leoki6/ENCE-4321/Phase_B/PCB_Design/V2/Phase_B_ATMEGA_v3/plots/Dimension_img.JPG

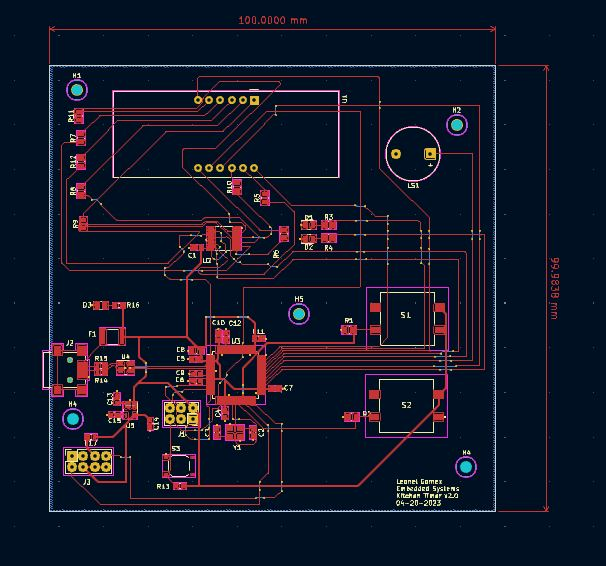
Phase_B/PCB_Design/V2/Phase_B_ATMEGA_v3/plots/Dimension_img.JPG
