leoki6/ENCE-4321/Phase_B/PCB_Design/V2/README.txt

The initial version of the folder Phase_B_ATMEGA_v3 was a template provided by Professor Martins
in ENCE-4231.

Files pertaining to the generation/creation of: housing, component placement, PCB dimensioning, Drill, Gerber, 3D Models, etc
were created by the author of this repository.
