leoki6/ENCE-4321/Phase_B/PCB_Design/V2/Phase_B_ATMEGA_v3/enclosure/V2/notes.txt

This version has the corner fillets removed and more accurately represents the true size of the PCB board.
