leoki6/ENCE-4321/Phase_D/Notes/block_diagram.pdf

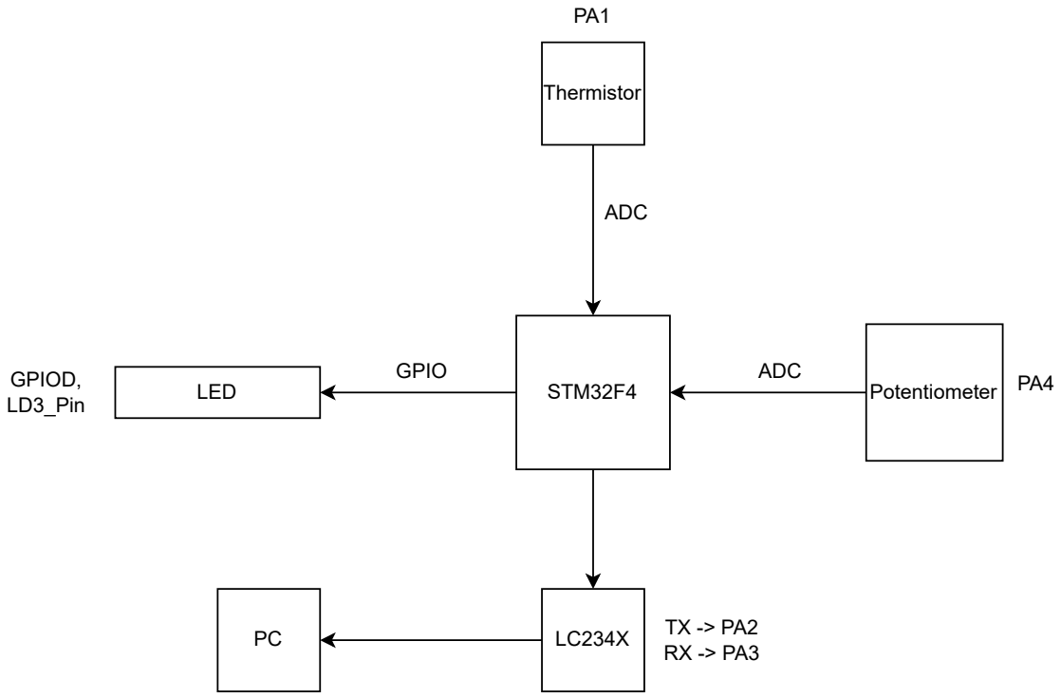
[picture p15: figure]
STM32F4; Thermistor; LED; Potentiometer GPIOD,; LD3_Pin; GPIO; ADC
