leoki6/ENCE-4321/Phase_B/Notes/Block_Diagrams/Phase_B_Sys_Diagram.pdf

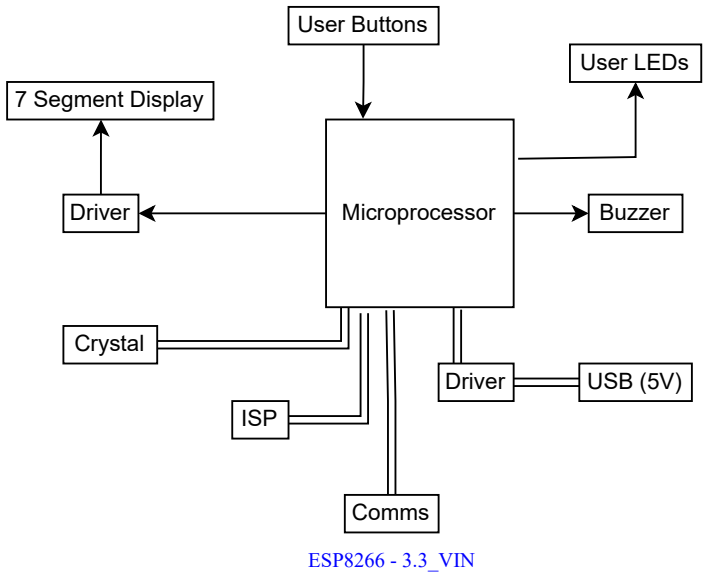
[picture p16: figure]
Microprocessor; User LEDs; User Buttons; Buzzer; USB (5V); Comms; ISP; Crystal; 7 Segment Display; Driver; ESP8266 - 3.3_VIN

Voltage Regulator

5V | 3V

Leonel Gomez; ENCE-4231; Phase_B_Sys_Diagram
