leoki6/ENCE-4321/Phase_B/PCB_Design/CURRENT/Phase_B_ATMEGA_v3/plots/kicad_backview.JPG

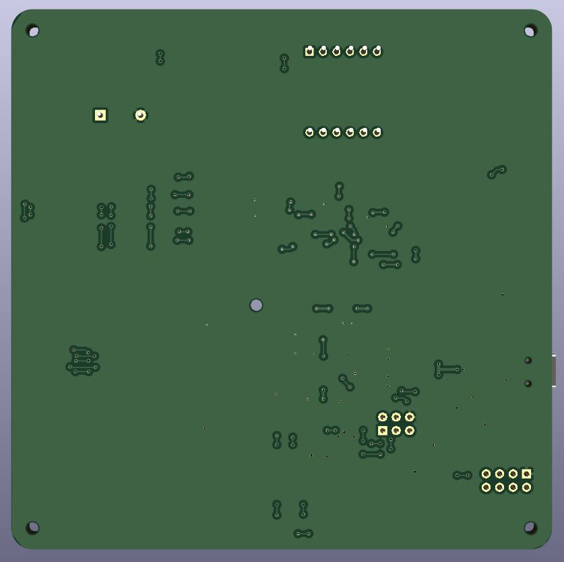
Phase_B/PCB_Design/CURRENT/Phase_B_ATMEGA_v3/plots/kicad_backview.JPG
