leoki6/ENCE-4321/Phase_B/PCB_Design/CURRENT/Phase_B_ATMEGA_v3/schematics/schematic.JPG

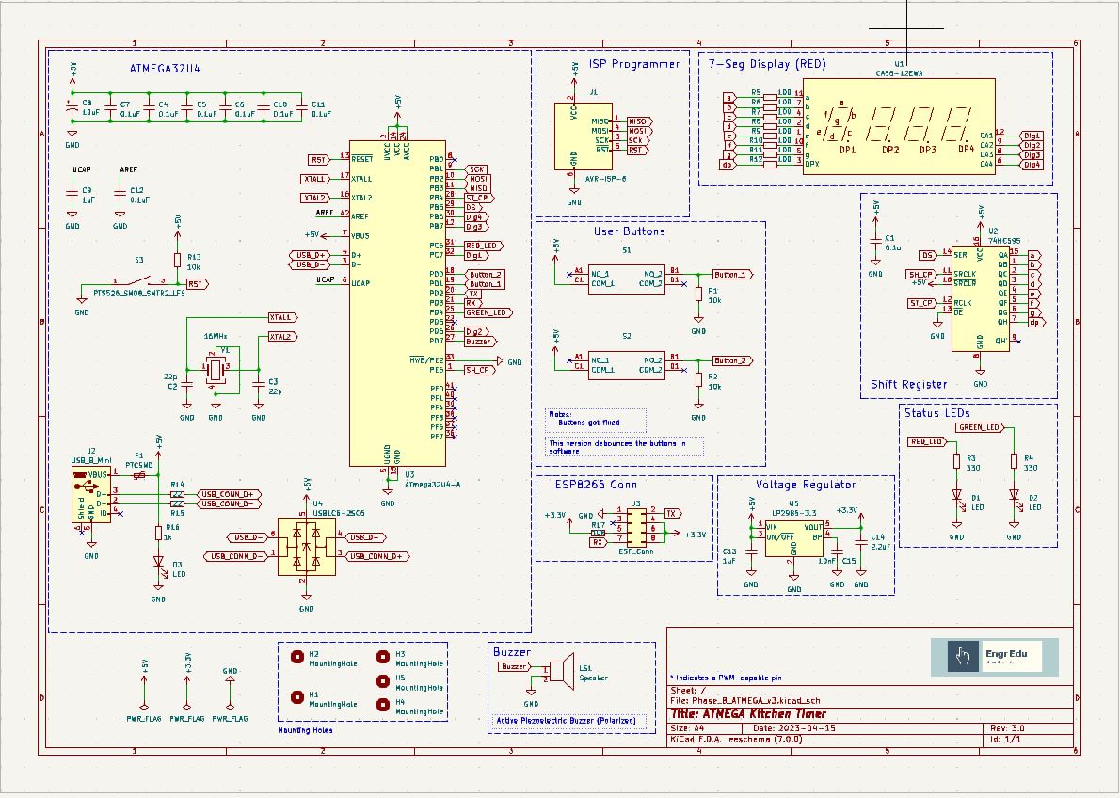
Phase_B/PCB_Design/CURRENT/Phase_B_ATMEGA_v3/schematics/schematic.JPG
