leoki6/ENCE-4321/Phase_D/Notes/simple_schematic.PNG

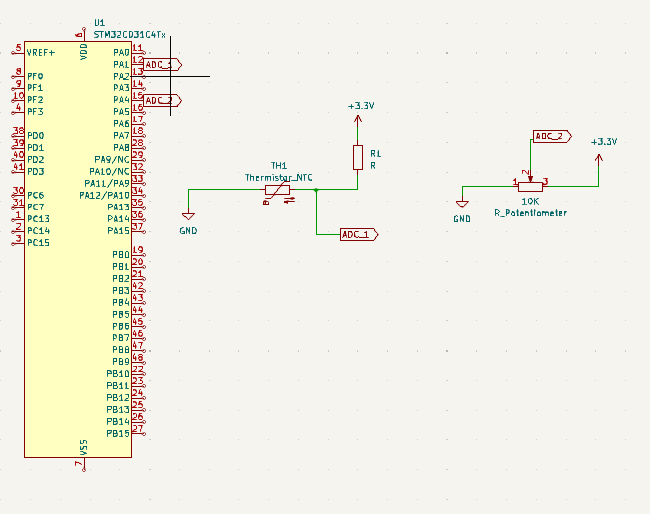
Phase_D/Notes/simple_schematic.PNG
