leoki6/ENCE-4321/Phase_D/PCB_Design/V1/plots/pcb_img.PNG

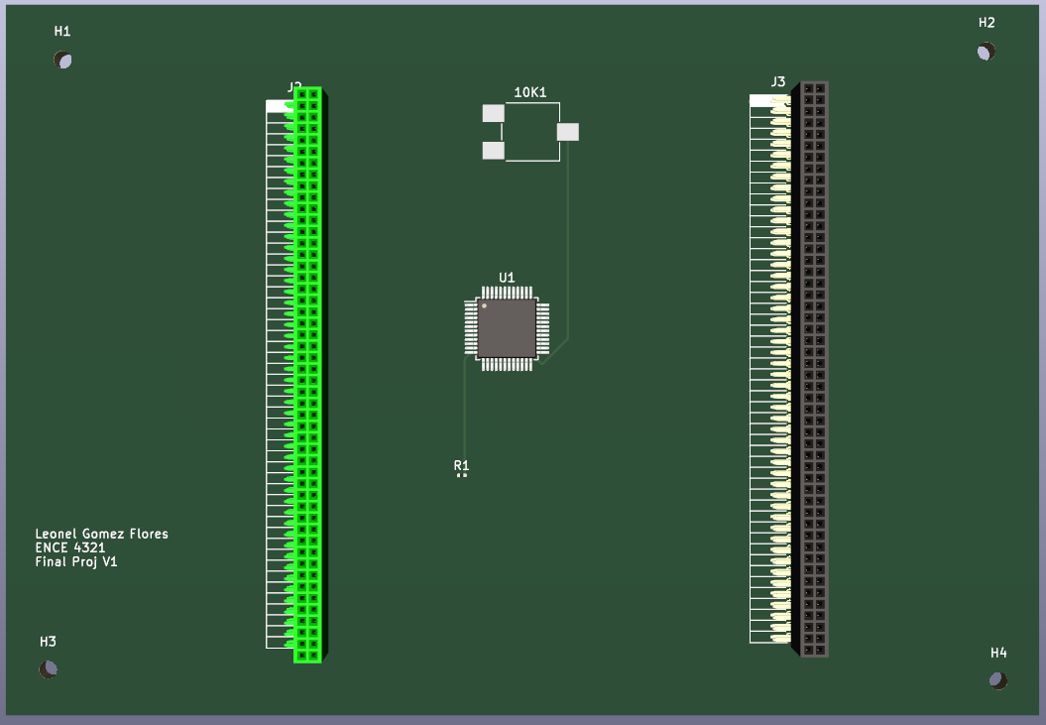
Phase_D/PCB_Design/V1/plots/pcb_img.PNG
