leoki6/ENCE-4321/Phase_D/PCB_Design/V1/schematics/schematic_img_v2.PNG

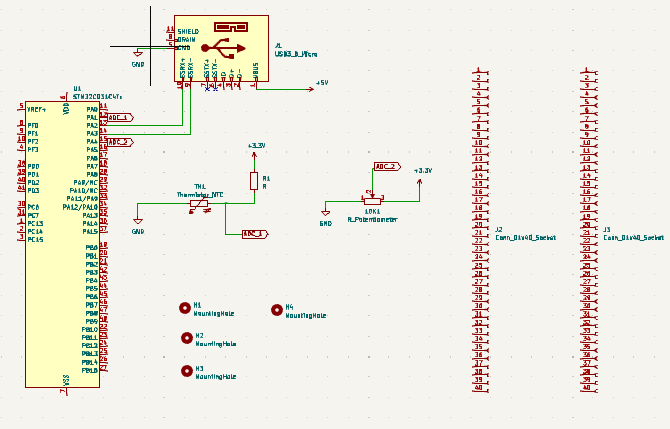
Phase_D/PCB_Design/V1/schematics/schematic_img_v2.PNG
