leoki6/ENCE-4321/Phase_B/PCB_Design/CURRENT/Phase_B_ATMEGA_v3/plots/DXF_Files/Phase_B_ATMEGA_v3-F_Cu.dxf

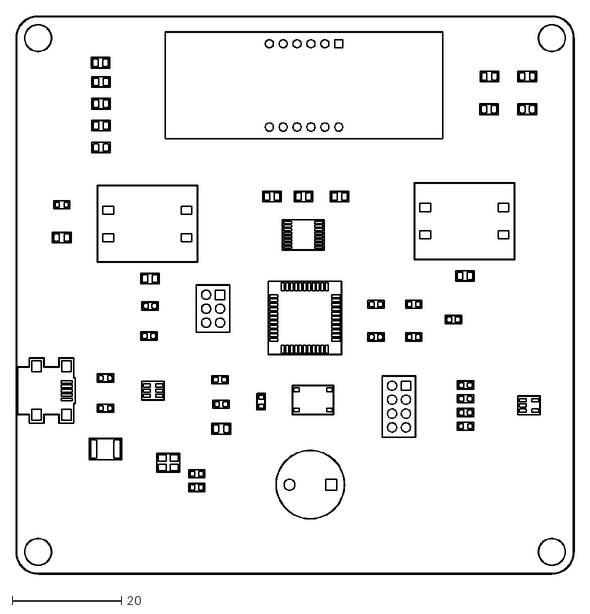
[picture p26: CAD file, 2023-04-18]
Phase_B/PCB_Design/CURRENT/Phase_B_ATMEGA_v3/plots/DXF_Files/Phase_B_ATMEGA_v3-F_Cu.dxf
102.1 x 102.1
