leoki6/ENCE-4321/Phase_B/PCB_Design/CURRENT/Phase_B_ATMEGA_v3/PTS125SM73SMTR21M_LFS.stp

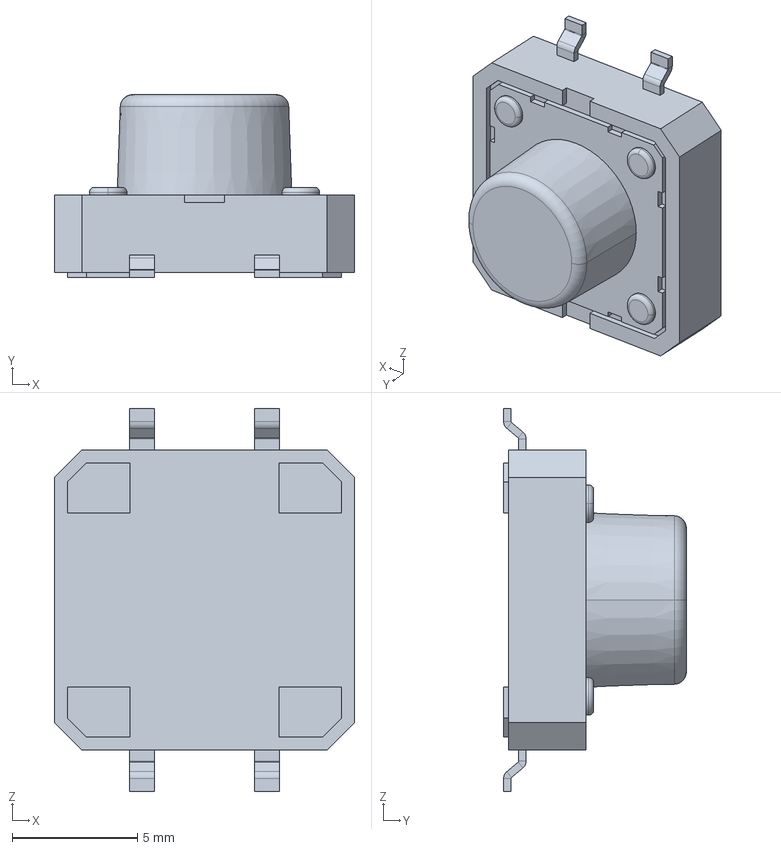
[picture p27: CAD file, 2023-04-18]
Phase_B/PCB_Design/CURRENT/Phase_B_ATMEGA_v3/PTS125SM73SMTR21M_LFS.stp
12.0 x 7.30 x 15.3 mm
