leoki6/ENCE-4321/Phase_B/PCB_Design/CURRENT/Phase_B_ATMEGA_v3/step/SW1_SW2_Models/PTS526_SM08_SMTR2_LFS.stp

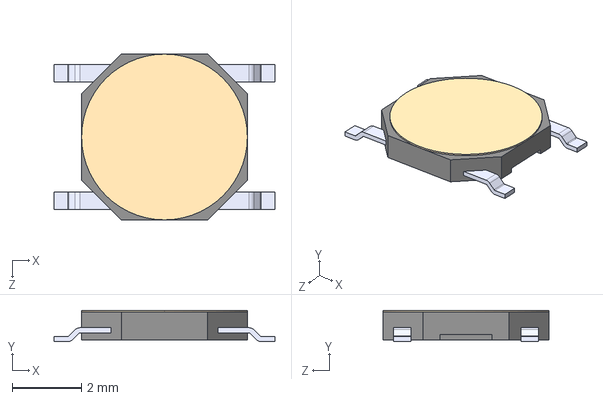
[picture p28: CAD file, 2023-04-18]
Phase_B/PCB_Design/CURRENT/Phase_B_ATMEGA_v3/step/SW1_SW2_Models/PTS526_SM08_SMTR2_LFS.stp
6.40 x 0.9 x 4.80 mm
