leoki6/ENCE-4321/Phase_B/PCB_Design/V2/Phase_B_ATMEGA_v3/components/PTS125_SMD_Button/STEP/PTS125_SMD_Button.stp

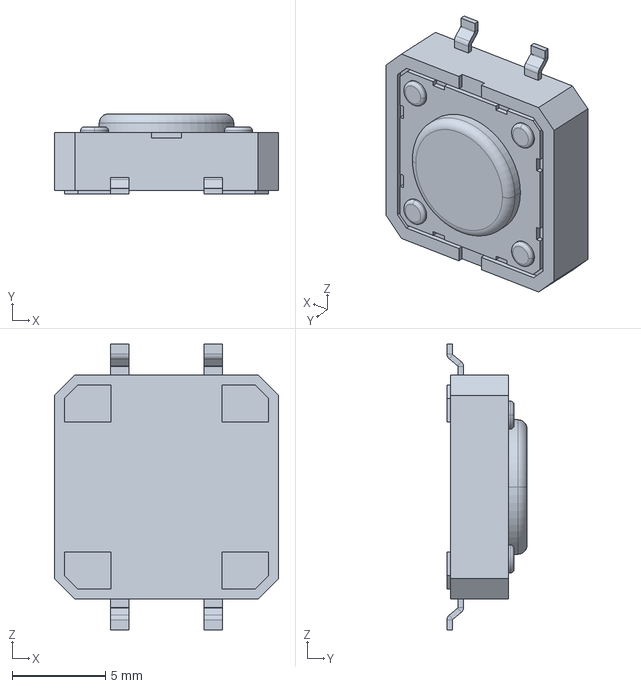
[picture p29: CAD file, 2023-04-12]
Phase_B/PCB_Design/V2/Phase_B_ATMEGA_v3/components/PTS125_SMD_Button/STEP/PTS125_SMD_Button.stp
12.0 x 4.30 x 15.3 mm
