leoki6/ENCE-4321/Phase_B/PCB_Design/V2/Phase_B_ATMEGA_v3/enclosure/V2/4.SLDPRT

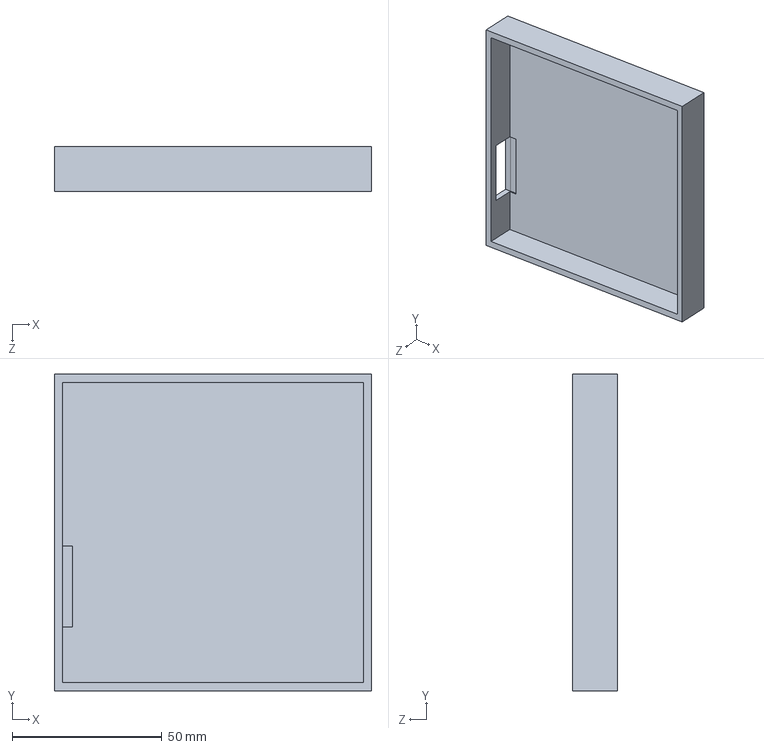
[picture p30: CAD file, 2023-05-04]
Phase_B/PCB_Design/V2/Phase_B_ATMEGA_v3/enclosure/V2/4.SLDPRT
106.0 x 106.0 x 15.0 mm
