leoki6/ENCE-4321/Phase_B/PCB_Design/V2/Phase_B_ATMEGA_v3/gerber/Phase_B_ATMEGA_v3-F_Cu.dxf

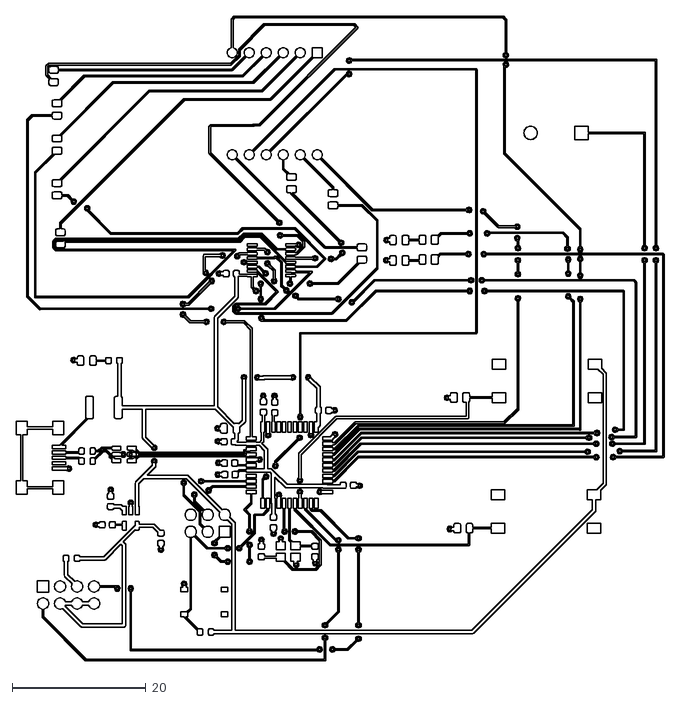
[picture p31: CAD file, 2023-05-04]
Phase_B/PCB_Design/V2/Phase_B_ATMEGA_v3/gerber/Phase_B_ATMEGA_v3-F_Cu.dxf
96.7 x 96.2
