leoki6/ENCE-4321/Phase_B/PCB_Design/V2/Phase_B_ATMEGA_v3/enclosure/V1/part.SLDPRT

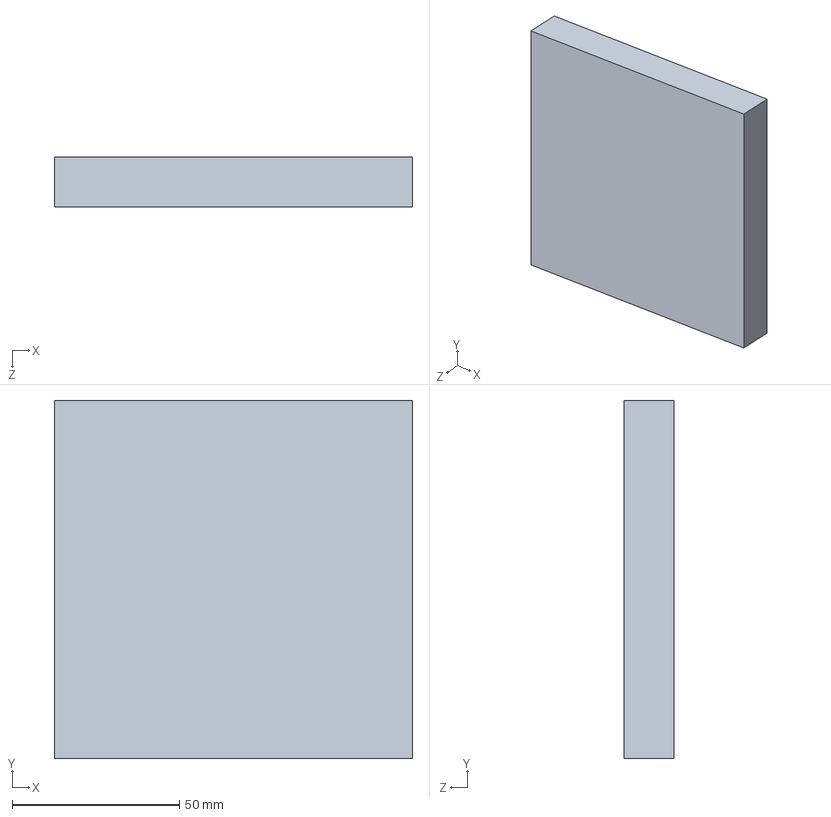
[picture p32: CAD file, 2023-04-18, an earlier design]
Phase_B/PCB_Design/V2/Phase_B_ATMEGA_v3/enclosure/V1/part.SLDPRT
107.0 x 107.0 x 15.0 mm
