leoki6/ENCE-4321/(list of files, cad)

Other CAD files:
Phase_B/PCB_Design/V2/Phase_B_ATMEGA_v3/components/PTS526_SMD_Button/STEP/PTS526_SMD_Button.step
Phase_B/PCB_Design/V2/Phase_B_ATMEGA_v3/enclosure/V2/housing_sld_part.SLDDRW
