leoki6/ENCE-4321/Phase_A/PCB_Design/Phase_A_UnoShield/schematics/Phase_A_UnoShield.pdf

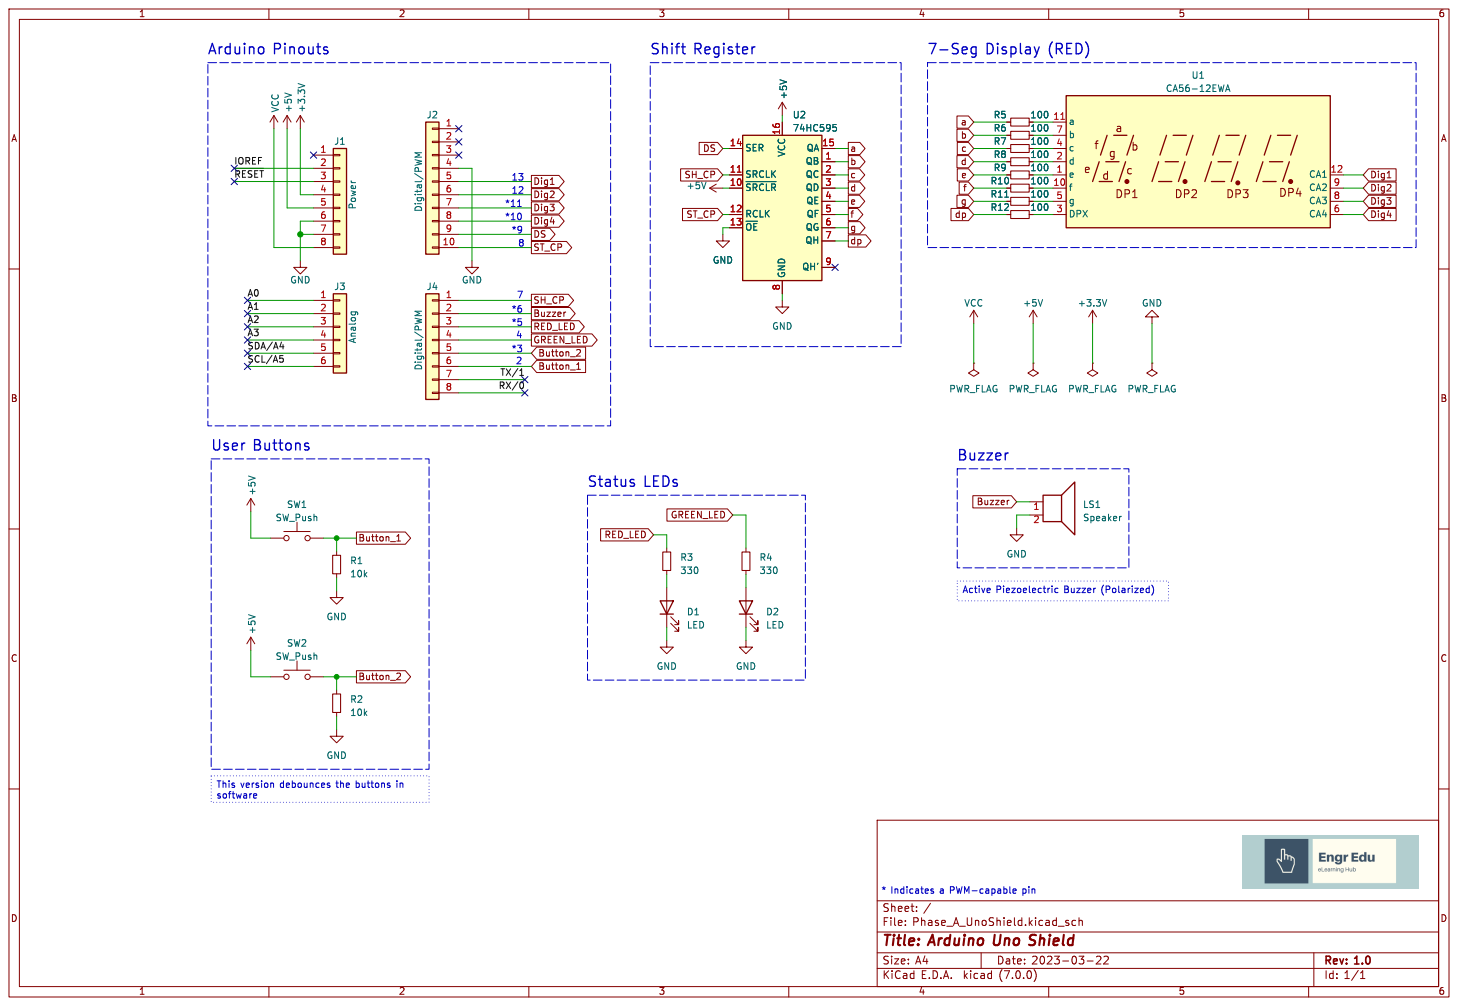
[picture p33: page 1]

Id: 1/1 Title: Arduino Uno Shield
