leoki6/ENCE-4321/Phase_B/PCB_Design/CURRENT/Phase_B_ATMEGA_v3/schematics/Phase_B_ATMEGA_v3.pdf

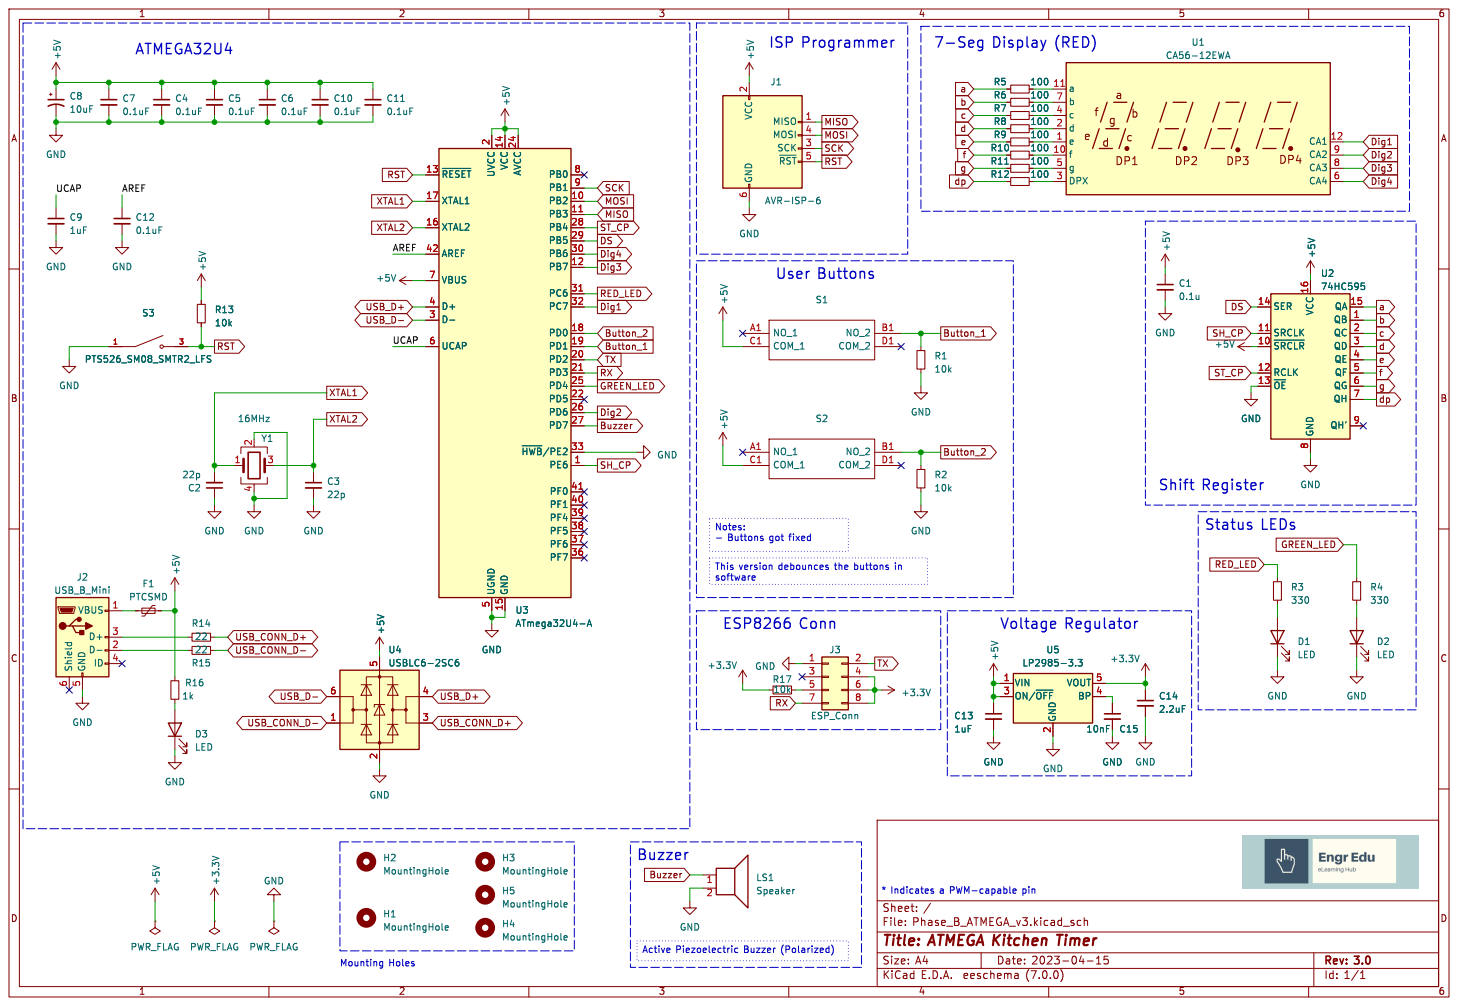
[picture p34: page 1]

2 SCK 3 MOSI 4 ~{RST}5 GND
22 GND

2 ON/~{OFF} 3 BP 4 VOUT 5 U5

2 ON/~{OFF} 3 BP 4 VOUT 5

Id: 1/1 Title: ATMEGA Kitchen Timer File: Phase_B_ATMEGA_v3.kicad_sch Sheet: / GND
