leoki6/ENCE-4321/Phase_B/PCB_Design/CURRENT/Phase_B_ATMEGA_v3/plots/Phase_B_ATMEGA_v3.pdf

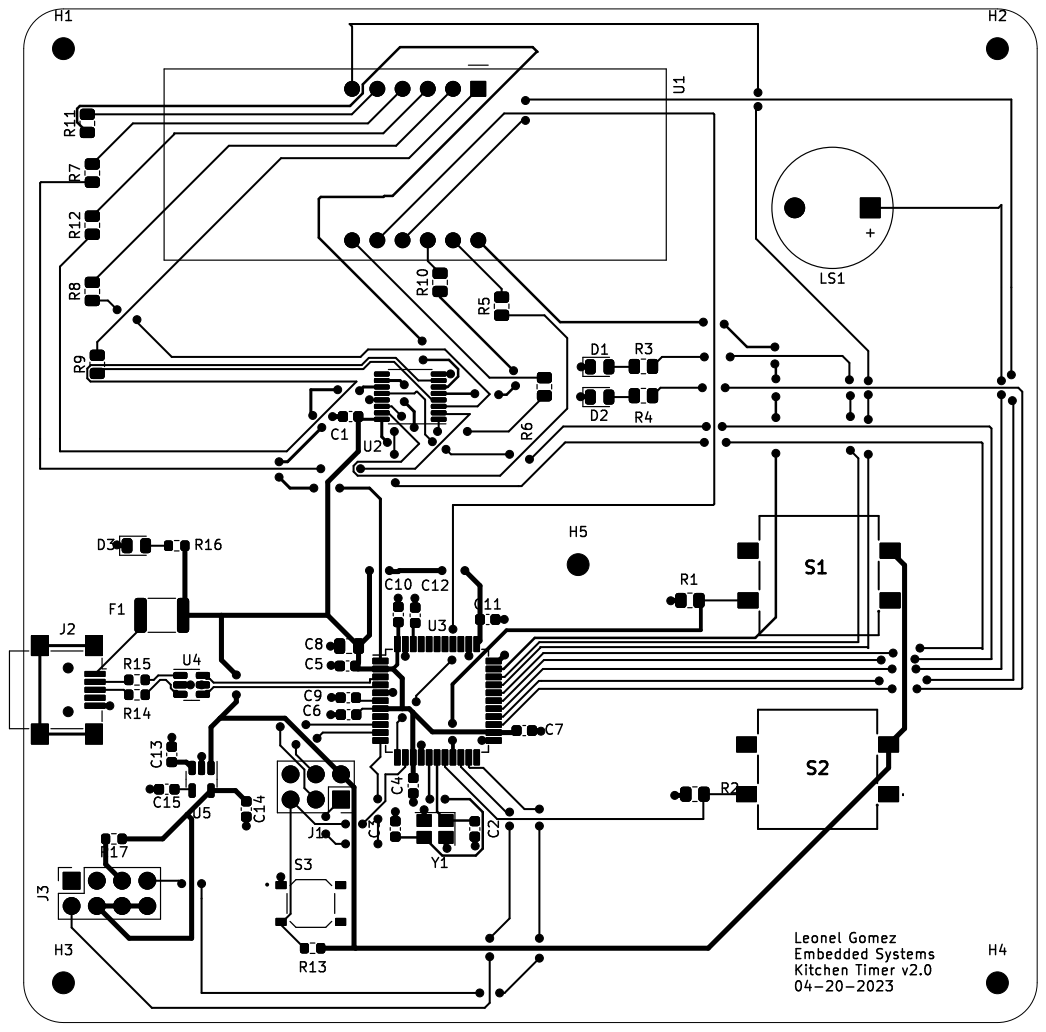
[picture p35: page 1]

Leonel Gomez Embedded Systems Kitchen Timer v2.0
