leoki6/ENCE-4321/Phase_B/PCB_Design/V2/Phase_B_ATMEGA_v3/enclosure/V2/Phase_B_Housing.pdf

6

5

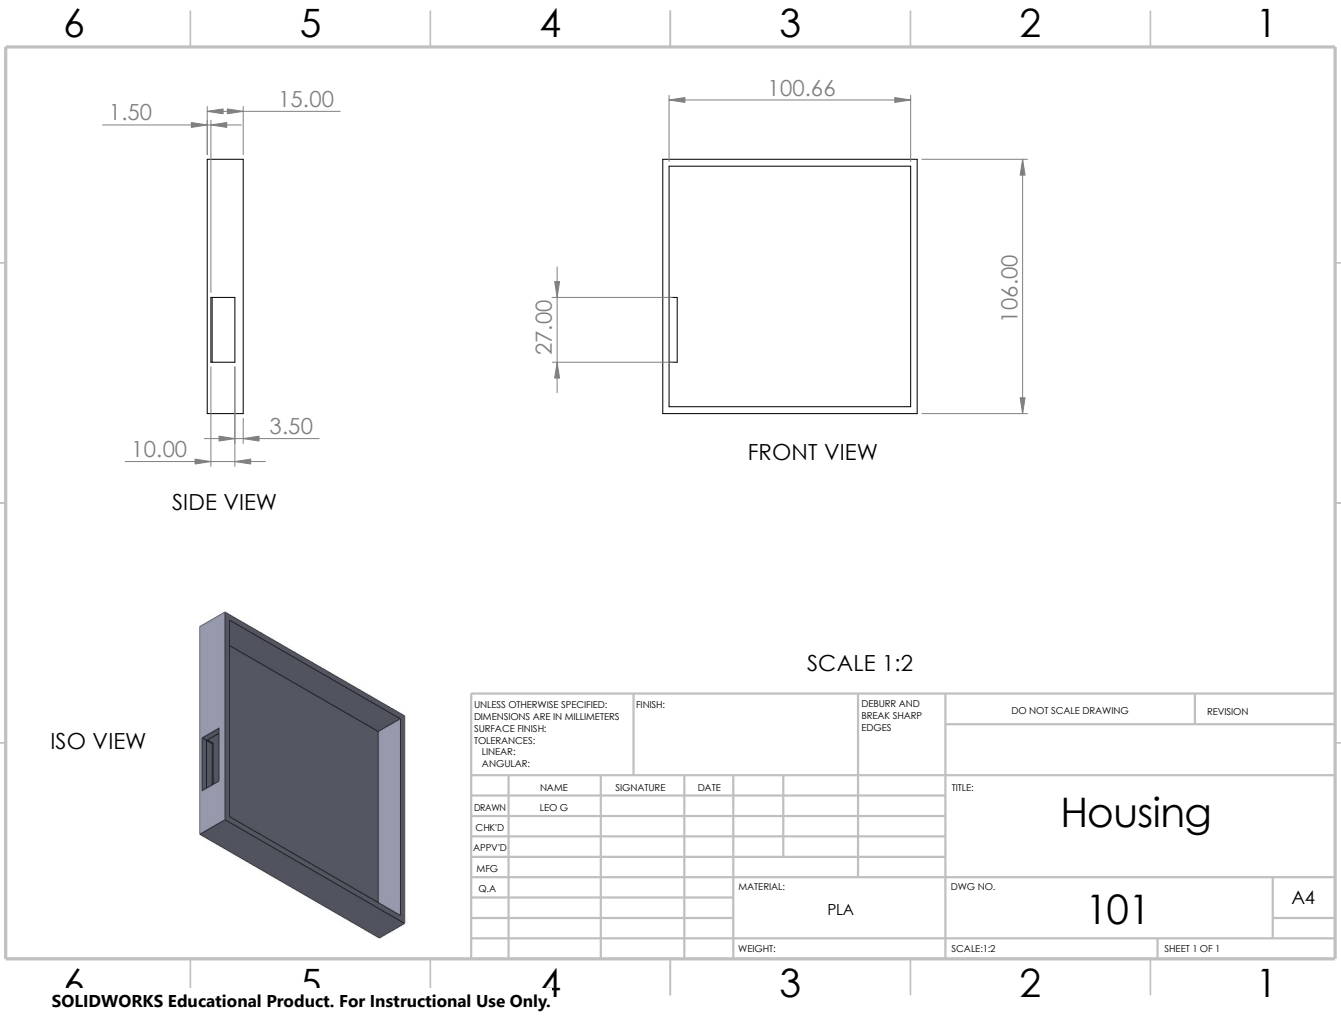
[picture p36: page 1]
WEIGHT:; SHEET 1 OF 1; FINISH:; EDGES; DO NOT SCALE DRAWING; REVISION; SCALE:1:2; DEBURR AND BREAK SHARP; SIDE VIEW; ISO VIEW; SCALE 1:2; FRONT VIEW

UNLESS OTHERWISE SPECIFIED:
DIMENSIONS ARE IN MILLIMETERS
SURFACE FINISH:
TOLERANCES:
LINEAR:
ANGULAR:

NAME | SIGNATURE | DATE | | | | TITLE: Housing

DRAWN | LEO G
CHK'D
APPV'D
Q.A | | | | MATERIAL: PLA | DWG NO. 101 | A4

MFG

SOLIDWORKS Educational Product. For Instructional Use Only.
