leoki6/ENCE-4321/Phase_A/Notes/Interrupt_Polling_Diagram.pdf

### MAIN

### Button_1_ISR

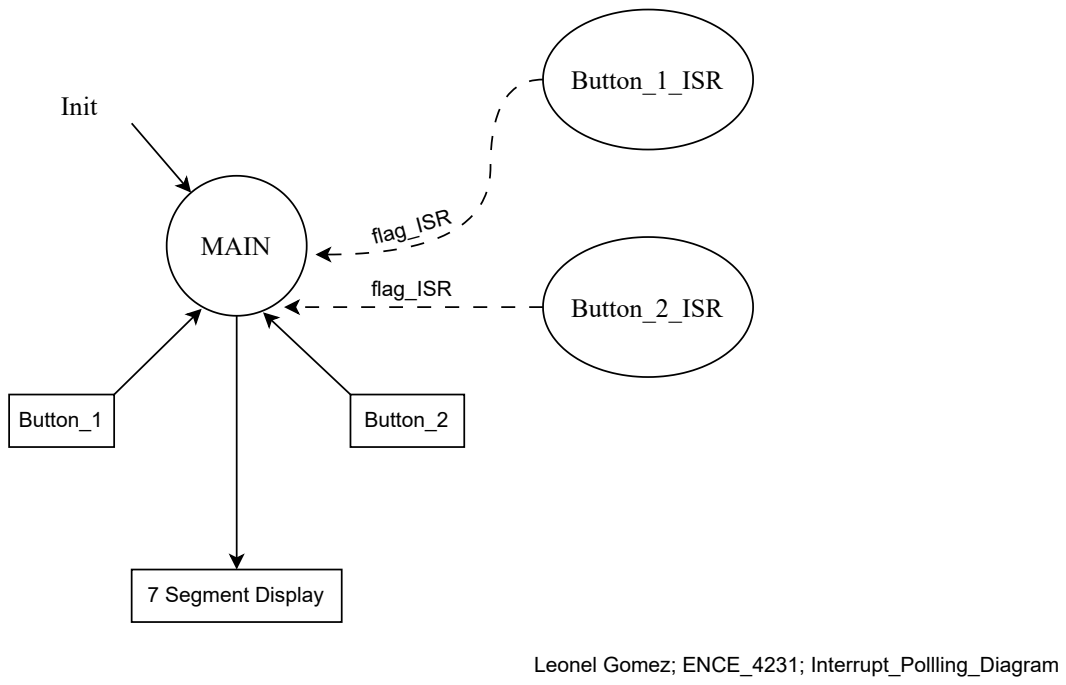
[picture p37: page 1]
Button_2_ISR; Init; Leonel Gomez; ENCE_4231; Interrupt_Pollling_Diagram; flag_ISR; 7 Segment Display; Button_1; Button_2
