leoki6/ENCE-4321/Phase_A/Notes/Simple_Counter_Diagram.pdf

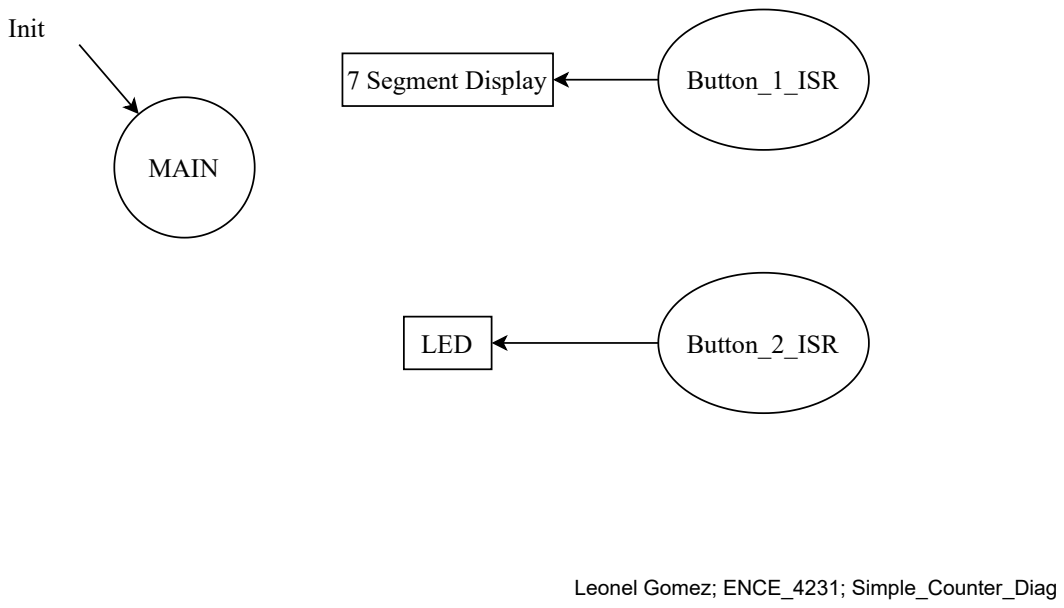
[picture p38: page 1]
MAIN; Button_1_ISR; Button_2_ISR; 7 Segment Display; LED; Init; Leonel Gomez; ENCE_4231; Simple_Counter_Diag
