leoki6/ENCE-4321/Phase_B/Notes/Block_Diagrams/soft_block_diag.pdf

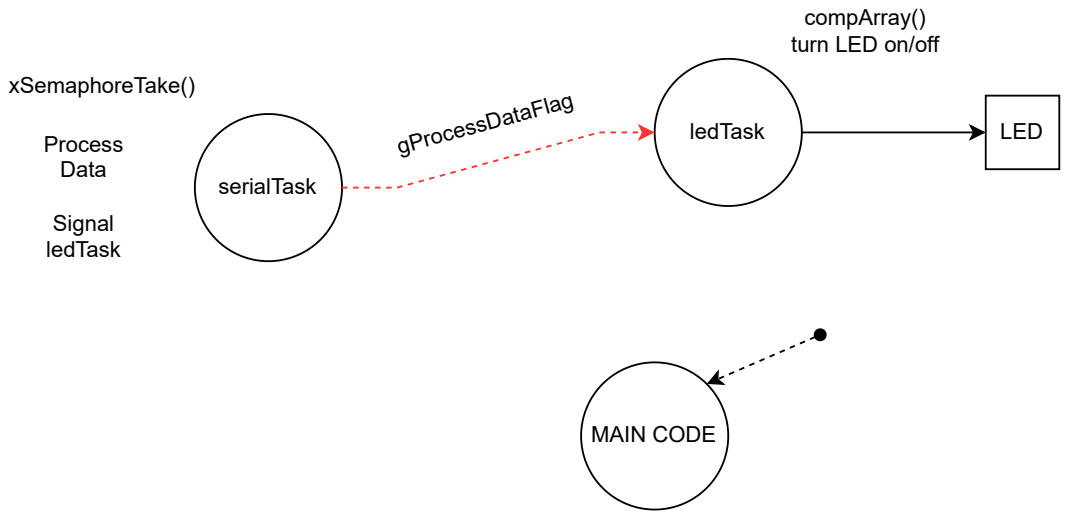
[picture p39: page 1]
MAIN CODE; LED; serialTask; ledTask gProcessDataFlag; xSemaphoreTake(); Process Data; Signal ledTask

compArray()
turn LED on/off
