leoki6/ENCE-4321/Phase_D/Notes/wiring_diag.pdf

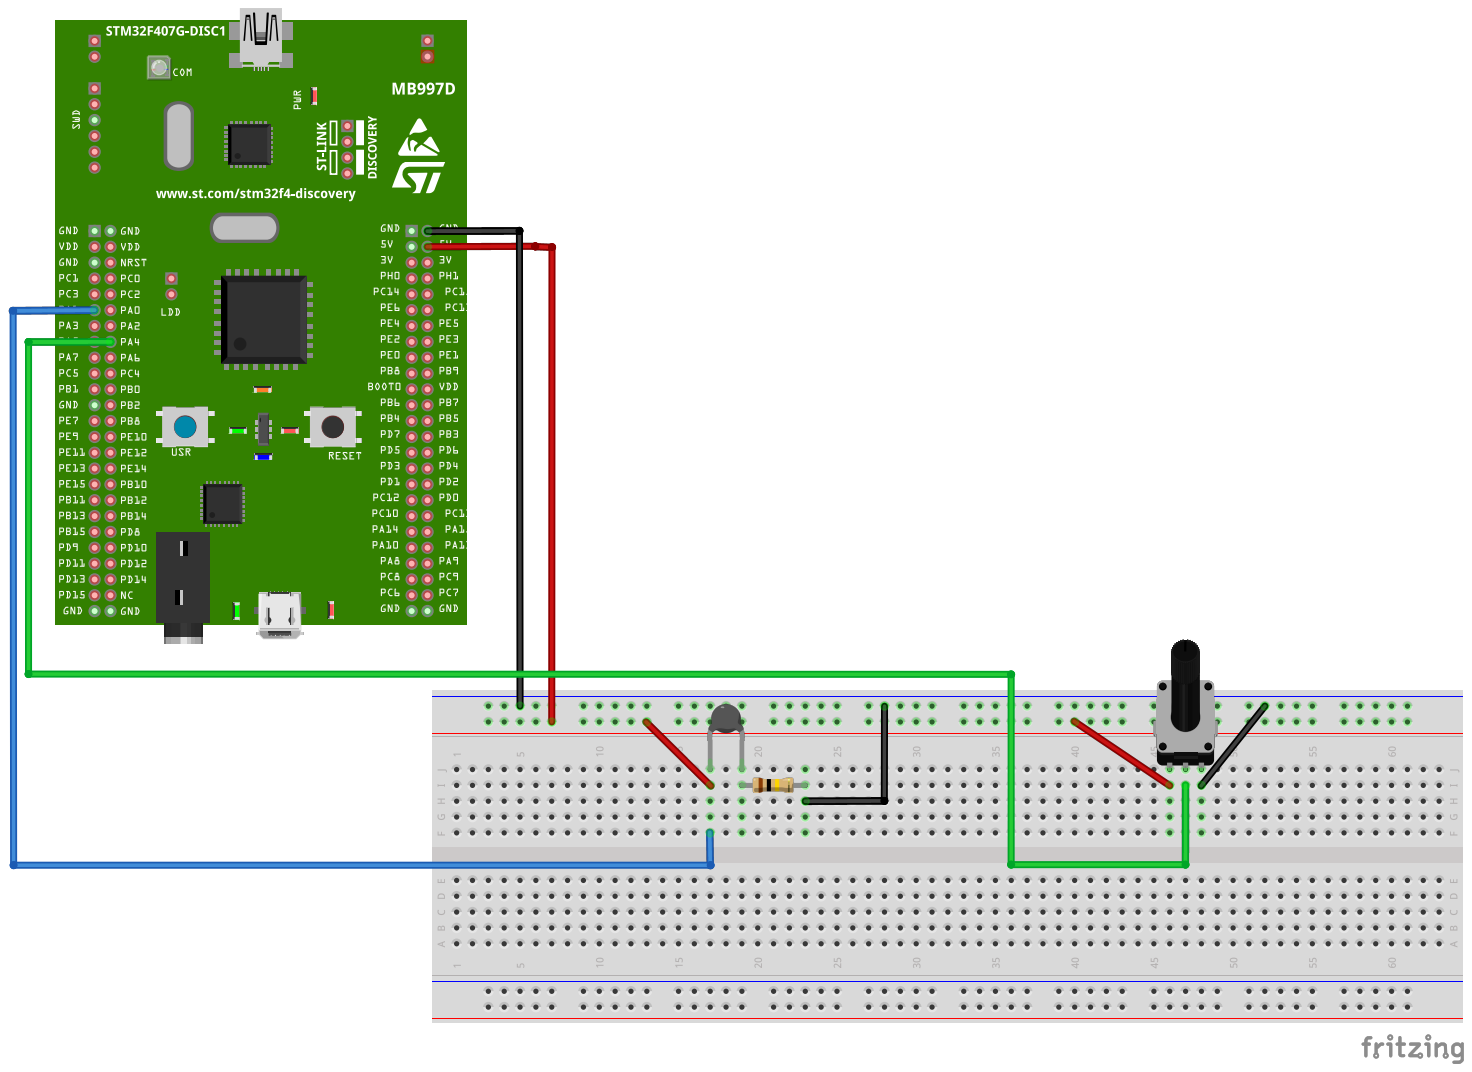
[picture p40: page 1]
