leoki6/ENCE-4321/Phase_D/PCB_Design/V1/schematics/schematic_kiCAD_v2.pdf

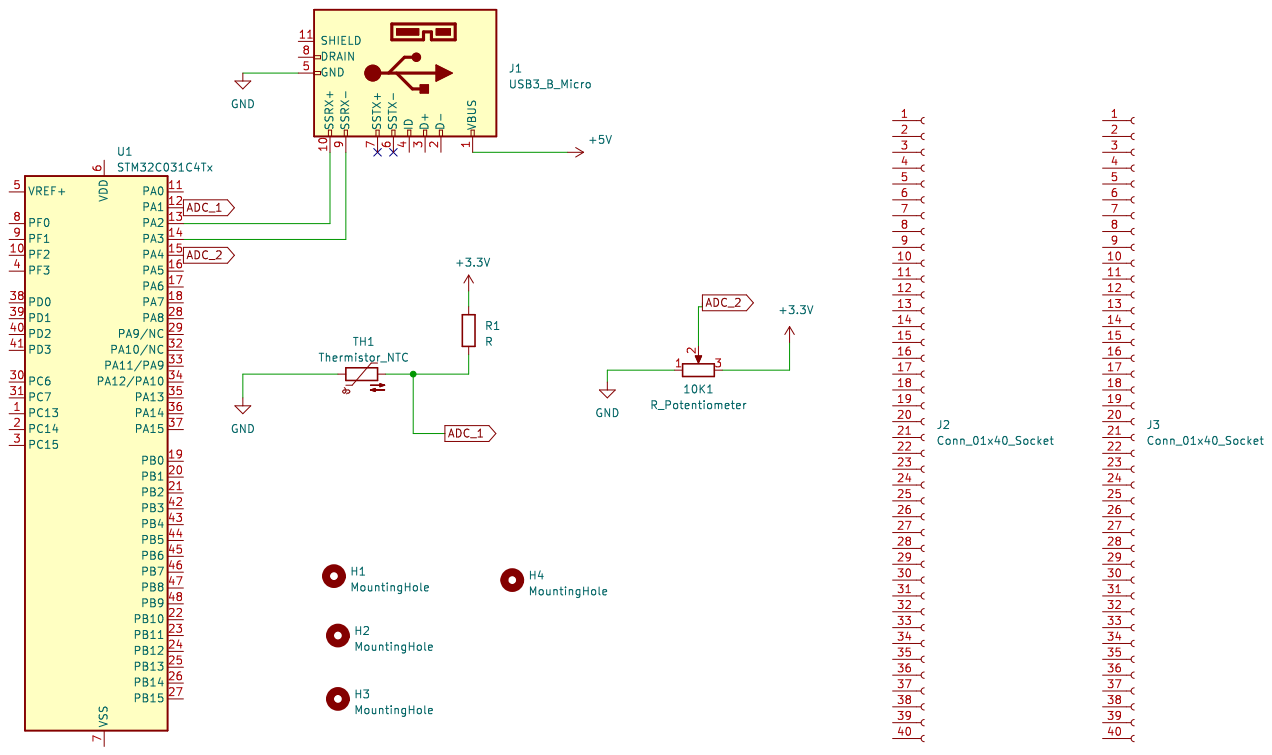
[picture p41: page 1]
