leoki6/ENCE-4321/Phase_A/PCB_Design/Phase_A_UnoShield/schematics/arduino_schematics.pdf

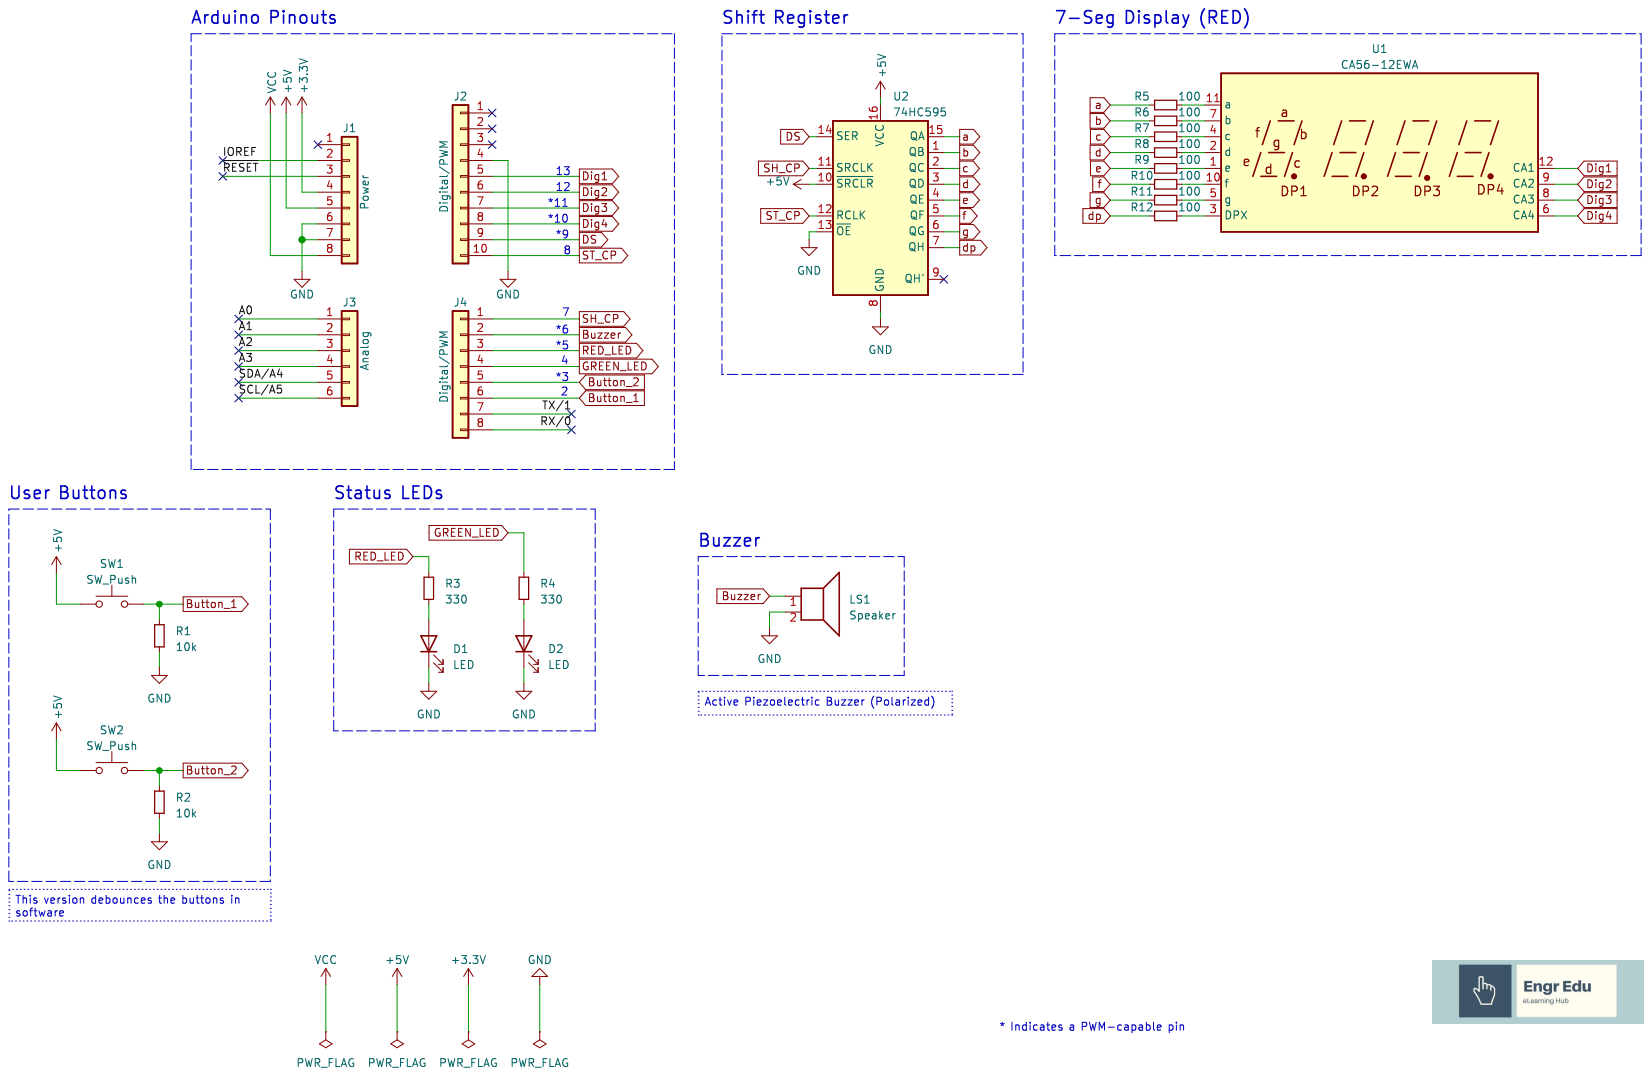
[picture p42: page 1]
