leoki6/ENCE-4321/Phase_D/PCB_Design/V1/schematics/schematic_kiCAD.pdf

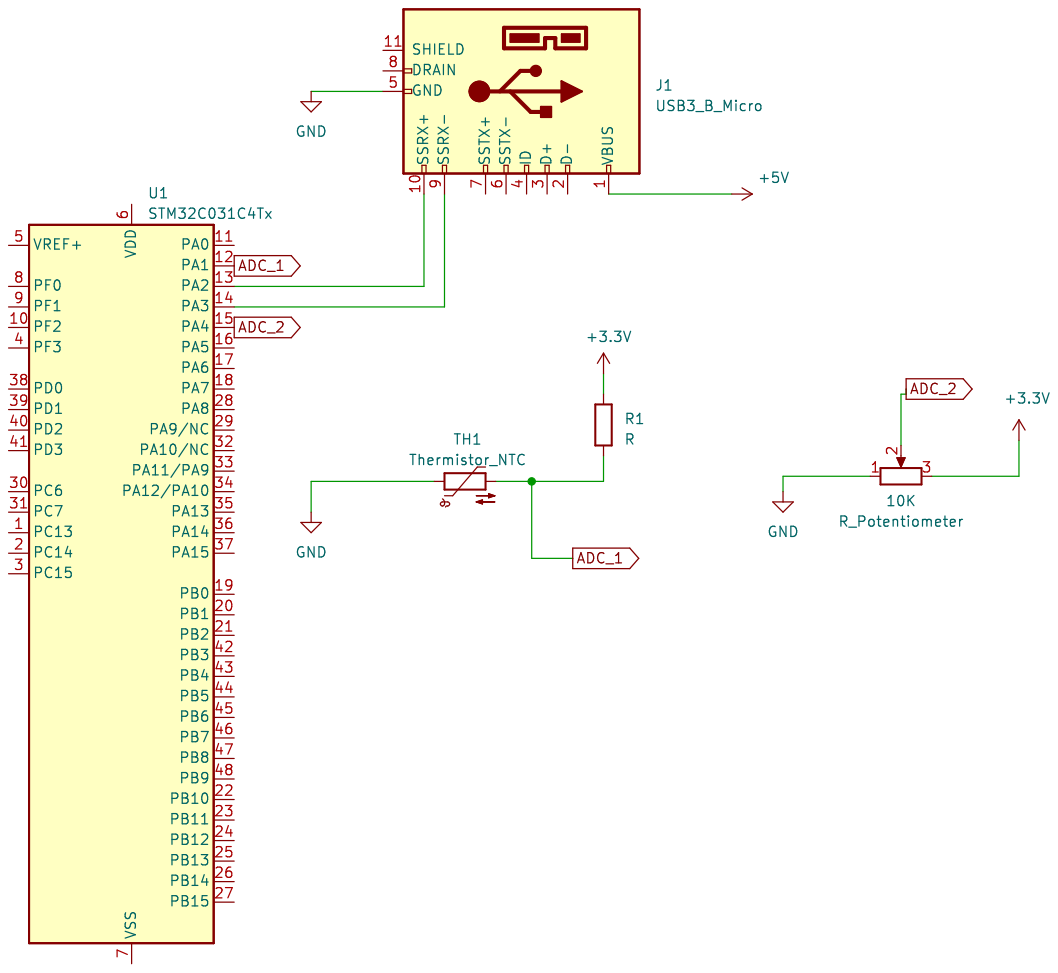
[picture p43: page 1]
