leoki6/ENCE-4321/Phase_D/PCB_Design/V1/V1.kicad_pcb

## KiCad design Phase_D/PCB_Design/V1/V1.kicad_pcb (2023-06-01)

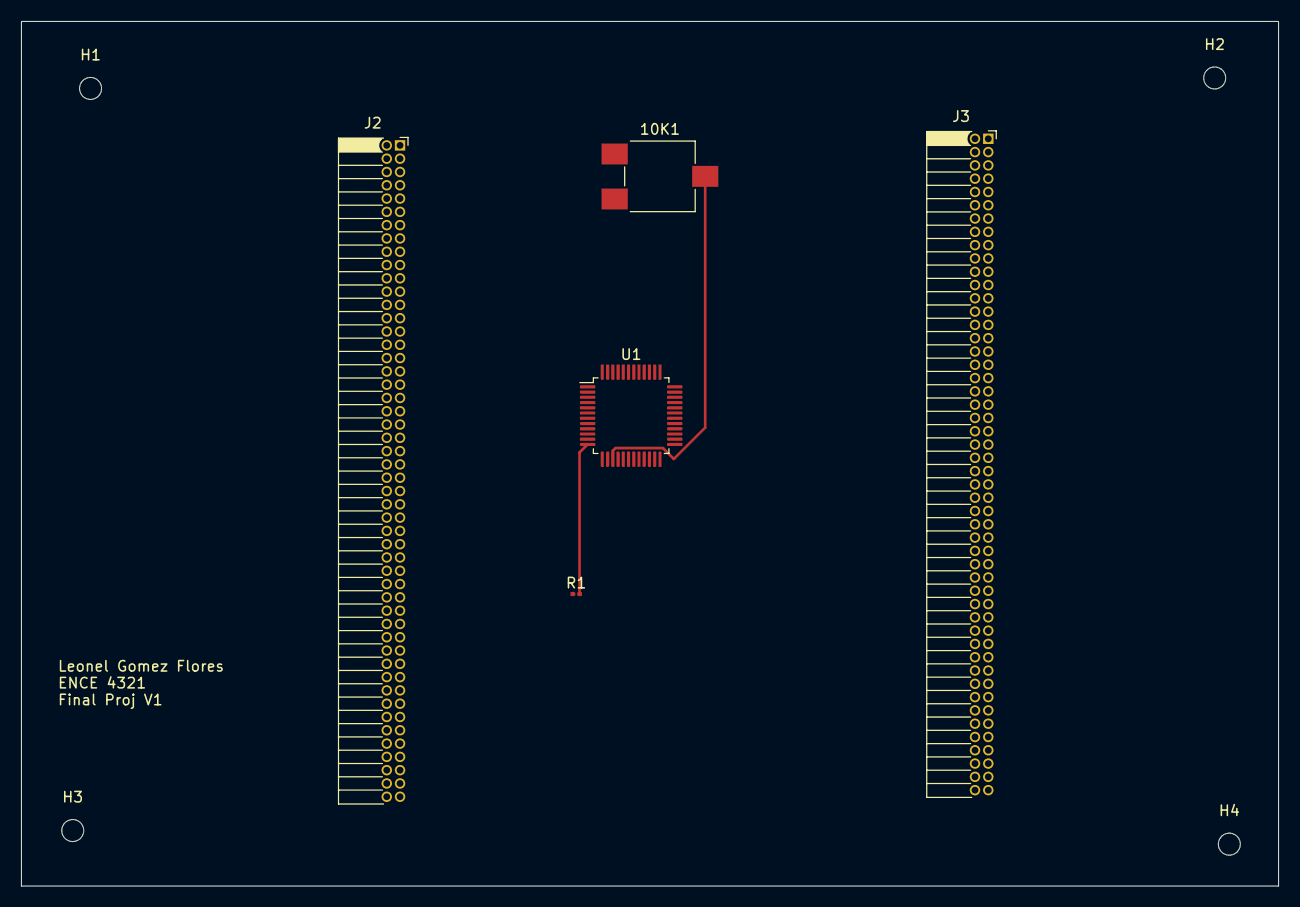
[picture p44: board V1.kicad_pcb from above]

Board: 2 copper layers, 120.1 x 82.6 mm, 9 parts (0 on the bottom side), 2 nets.

Parts:
10K1: R_Potentiometer; Potentiometer_ACP_CA6-VSMD_Vertical
H1, H2, H3, H4: MountingHole; MountingHole_2.1mm
J2, J3: Conn_01x40_Socket; PinSocket_2x50_P1.27mm_Horizontal
R1: R; R_0201_0603Metric
U1: STM32C031C4Tx; LQFP-48_7x7mm_P0.5mm

Connections:
ADC_1: R1.2, U1.12 (PA1)
ADC_2: 10K1.2, U1.15 (PA4)
