leoki6/ENCE-4321/Phase_B/PCB_Design/V2/Phase_B_ATMEGA_v3/Phase_B_ATMEGA_v3.kicad_pcb

## KiCad design Phase_B/PCB_Design/V2/Phase_B_ATMEGA_v3/Phase_B_ATMEGA_v3.kicad_pcb (2023-05-04)

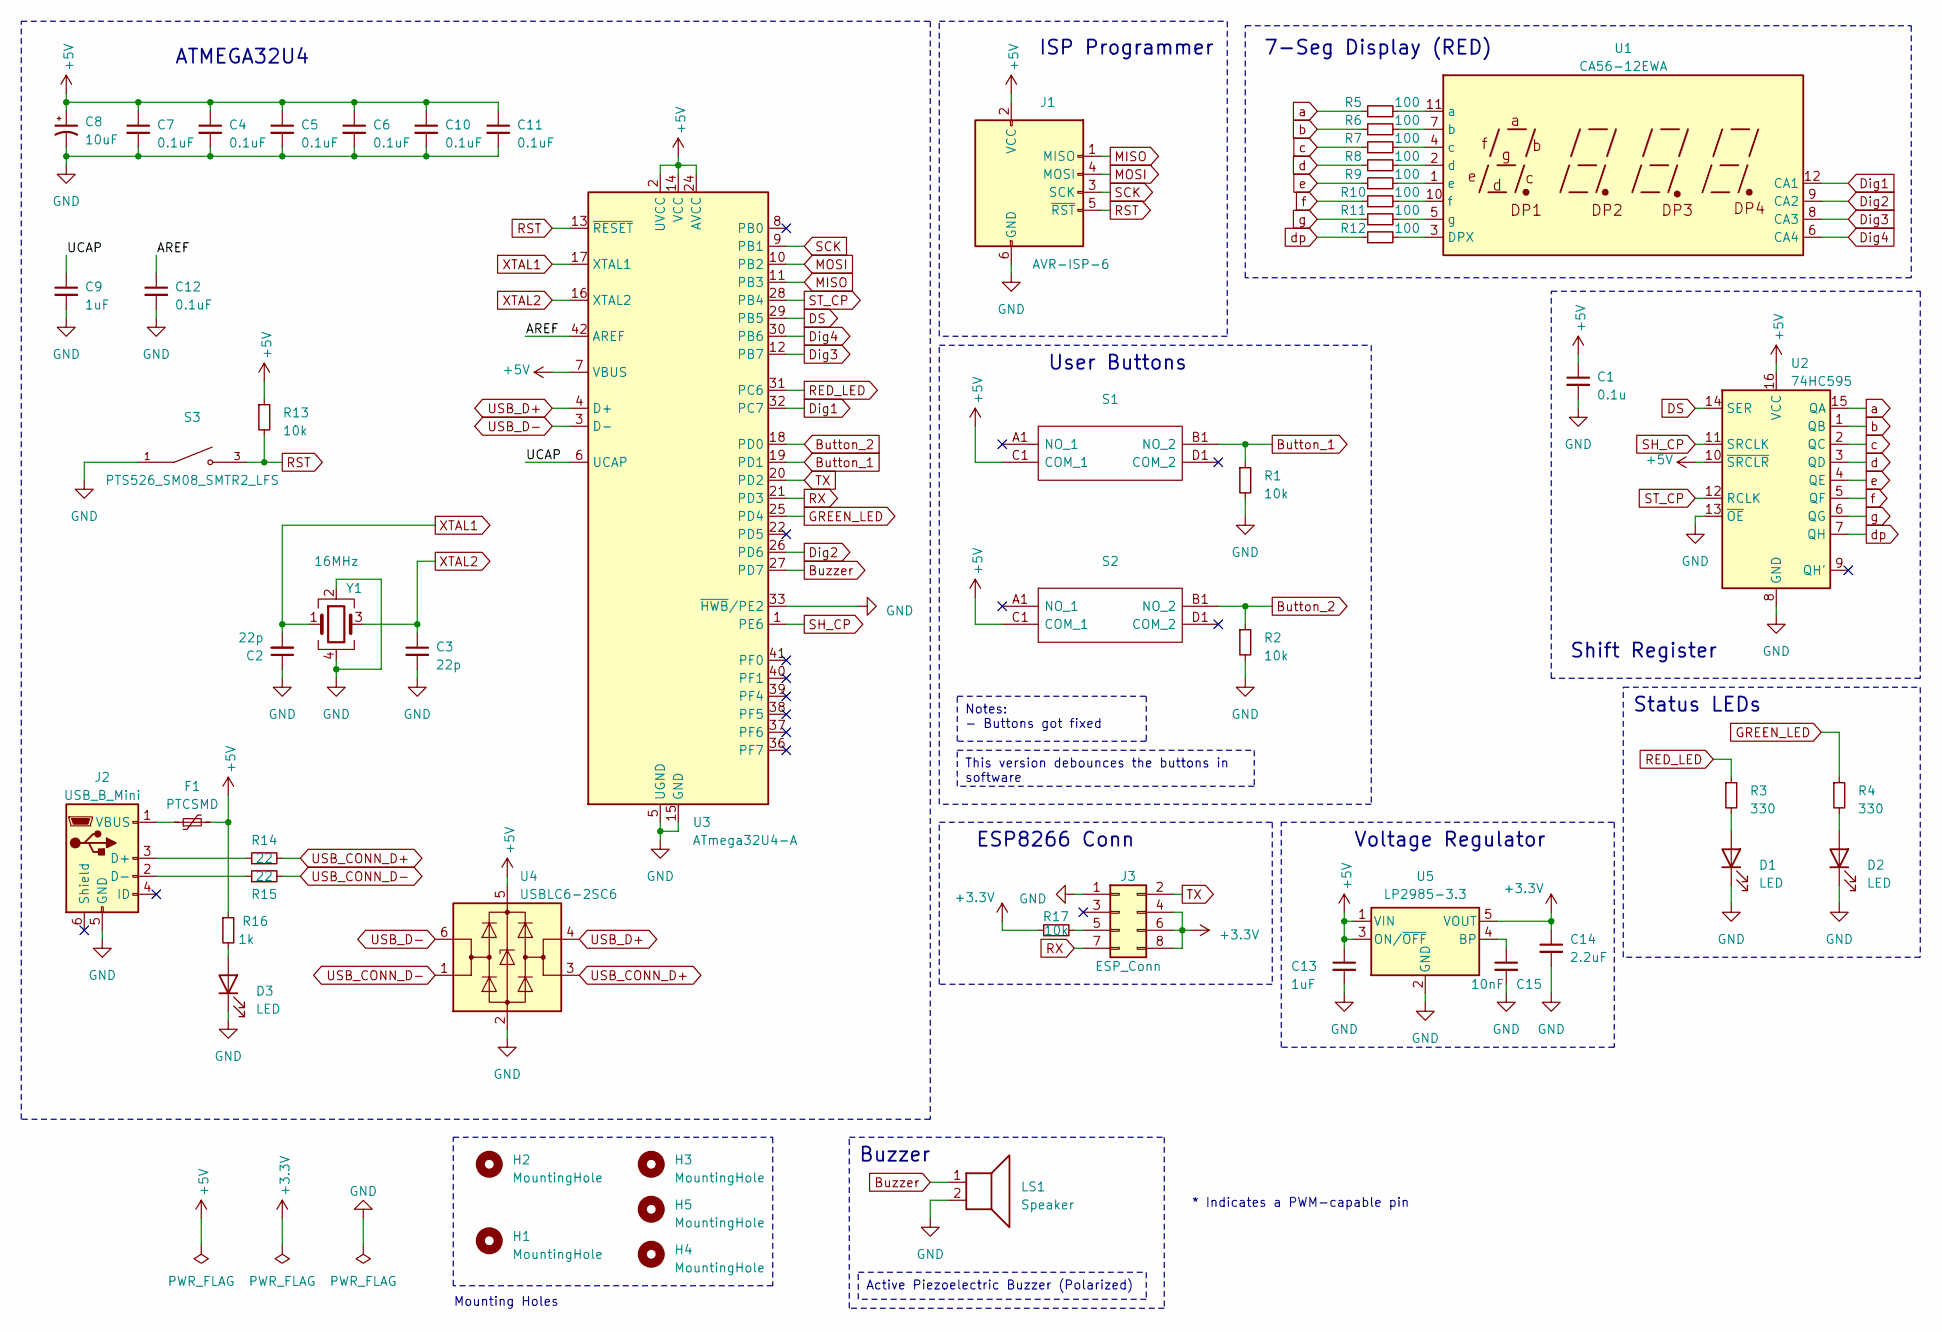
[picture p45: schematic Phase_B_ATMEGA_v3.kicad_sch, ATMEGA Kitchen Timer]

Parts:
C1: 0.1u; C_0603_1608Metric
C2, C3: 22p; C_0603_1608Metric
C4, C5, C6, C7, C10, C11, C12: 0.1uF; C_0603_1608Metric
C8: 10uF; C_0805_2012Metric
C9, C13: 1uF; C_0603_1608Metric
C14: 2.2uF; C_0603_1608Metric
C15: 10nF; C_0603_1608Metric
D1, D2, D3: LED; LED_0805_2012Metric
F1: PTCSMD; Fuse_1812_4532Metric
H1, H2, H3, H4, H5: MountingHole; MountingHole_2.2mm_M2
J1: AVR-ISP-6; PinSocket_2x03_P2.54mm_Vertical
J2: USB_B_Mini; USB_Mini-B_Lumberg_2486_01_Horizontal
J3: ESP_Conn; PinSocket_2x04_P2.54mm_Vertical
LS1: Speaker; Buzzer_12x9.5RM7.6
R1, R2: 10k; R_0805_2012Metric
R3, R4: 330; R_0805_2012Metric
R5, R6, R7, R8, R9, R10, R11, R12: 100; R_0805_2012Metric
R13, R17: 10k; R_0603_1608Metric
R14, R15: 22; R_0603_1608Metric
R16: 1k; R_0603_1608Metric
S1, S2: PTS125SM43SMTR21M_LFS; PTS125_SMD_Button; Manufacturer_Part_Number PTS125SM43SMTR21M LFS; Mouser Part Number 611-PTS125S43SMTRLFS
S3: PTS526_SM08_SMTR2_LFS; PTS526_SMD_Button; PARTREV 20 mar 19
U1: CA56-12EWA
U2: 74HC595; TSSOP-16_4.4x5mm_P0.65mm
U3: ATmega32U4-A; TQFP-44_10x10mm_P0.8mm
U4: USBLC6-2SC6; SOT-23-6
U5: LP2985-3.3; SOT-23-5
Y1: 16MHz; Crystal_SMD_Abracon_ABM8G-4Pin_3.2x2.5mm

Connections:
+3.3V: C14.1, J3.4, J3.6, J3.8, R17.1, U5.5 (VOUT)
+5V: C1.1, C4.1, C5.1, C6.1, C7.1, C8.1, C10.1, C11.1, C13.1, F1.2, J1.2 (VCC), R13.1, R16.1, S1.C1 (COM_1), S2.C1 (COM_1), U2.10 (~SRCLR), U2.16 (VCC), U3.2 (UVCC), U3.7 (VBUS), U3.14 (VCC), U3.24 (AVCC), U3.34 (VCC), U3.44 (AVCC), U4.5 (VBUS), U5.1 (VIN), U5.3 (ON/~OFF)
/AREF: C12.1, U3.42 (AREF)
/UCAP: C9.1, U3.6 (UCAP)
Button_1: R1.1, S1.B1 (NO_2), U3.19 (PD1)
Button_2: R2.1, S2.B1 (NO_2), U3.18 (PD0)
Buzzer: LS1.1, U3.27 (PD7)
DS: U2.14 (SER), U3.29 (PB5)
Dig1: U1.12 (CA1), U3.32 (PC7)
Dig2: U1.9 (CA2), U3.26 (PD6)
Dig3: U1.8 (CA3), U3.12 (PB7)
Dig4: U1.6 (CA4), U3.30 (PB6)
GND: C1.2, C2.1, C3.2, C4.2, C5.2, C6.2, C7.2, C8.2, C9.2, C10.2, C11.2, C12.2, C13.2, C14.2, C15.2, D1.1 (K), D2.1 (K), D3.1 (K), J1.6 (GND), J2.5 (GND), J3.1, LS1.2, R1.2, R2.2, S3.1, U2.8 (GND), U2.13 (~OE), U3.5 (UGND), U3.15 (GND), U3.23 (GND), U3.33 (~HWB/PE2), U3.35 (GND), U3.43 (GND), U4.2 (GND), U5.2 (GND), Y1.2, Y1.4
GREEN_LED: R4.1, U3.25 (PD4)
MISO: J1.1 (MISO), U3.11 (PB3)
MOSI: J1.4 (MOSI), U3.10 (PB2)
unnamed: D1.2 (A), R3.2
unnamed: D2.2 (A), R4.2
unnamed: D3.2 (A), R16.2
unnamed: J2.3 (D+), R14.1
unnamed: J2.2 (D-), R15.1
unnamed: F1.1, J2.1 (VBUS)
unnamed: J3.5, R17.2
unnamed: R12.2, U1.3 (DPX)
unnamed: R5.2, U1.11 (a)
unnamed: R6.2, U1.7 (b)
unnamed: R7.2, U1.4 (c)
unnamed: R8.2, U1.2 (d)
unnamed: R9.2, U1.1 (e)
unnamed: R10.2, U1.10 (f)
unnamed: R11.2, U1.5 (g)
unnamed: C15.1, U5.4 (BP)
RED_LED: R3.1, U3.31 (PC6)
RST: J1.5 (~RST), R13.2, S3.3, U3.13 (~RESET)
RX: J3.7, U3.21 (PD3)
SCK: J1.3 (SCK), U3.9 (PB1)
SH_CP: U2.11 (SRCLK), U3.1 (PE6)
ST_CP: U2.12 (RCLK), U3.28 (PB4)
TX: J3.2, U3.20 (PD2)
USB_CONN_D+: R14.2, U4.3 (I/O2)
USB_CONN_D-: R15.2, U4.1 (I/O1)
USB_D+: U3.4 (D+), U4.4 (I/O2)
USB_D-: U3.3 (D-), U4.6 (I/O1)
XTAL1: C2.2, U3.17 (XTAL1), Y1.1
XTAL2: C3.1, U3.16 (XTAL2), Y1.3
a: R5.1, U2.15 (QA)
b: R6.1, U2.1 (QB)
c: R7.1, U2.2 (QC)
d: R8.1, U2.3 (QD)
dp: R12.1, U2.7 (QH)
e: R9.1, U2.4 (QE)
f: R10.1, U2.5 (QF)
g: R11.1, U2.6 (QG)

Notes on the sheet:
Notes: - Buttons got fixed
Active Piezoelectric Buzzer (Polarized)
This version debounces the buttons in software
Shift Register
Mounting Holes
Voltage Regulator
Status LEDs
ATMEGA32U4
User Buttons
Buzzer
* Indicates a PWM-capable pin
7-Seg Display (RED)
ISP Programmer
ESP8266 Conn

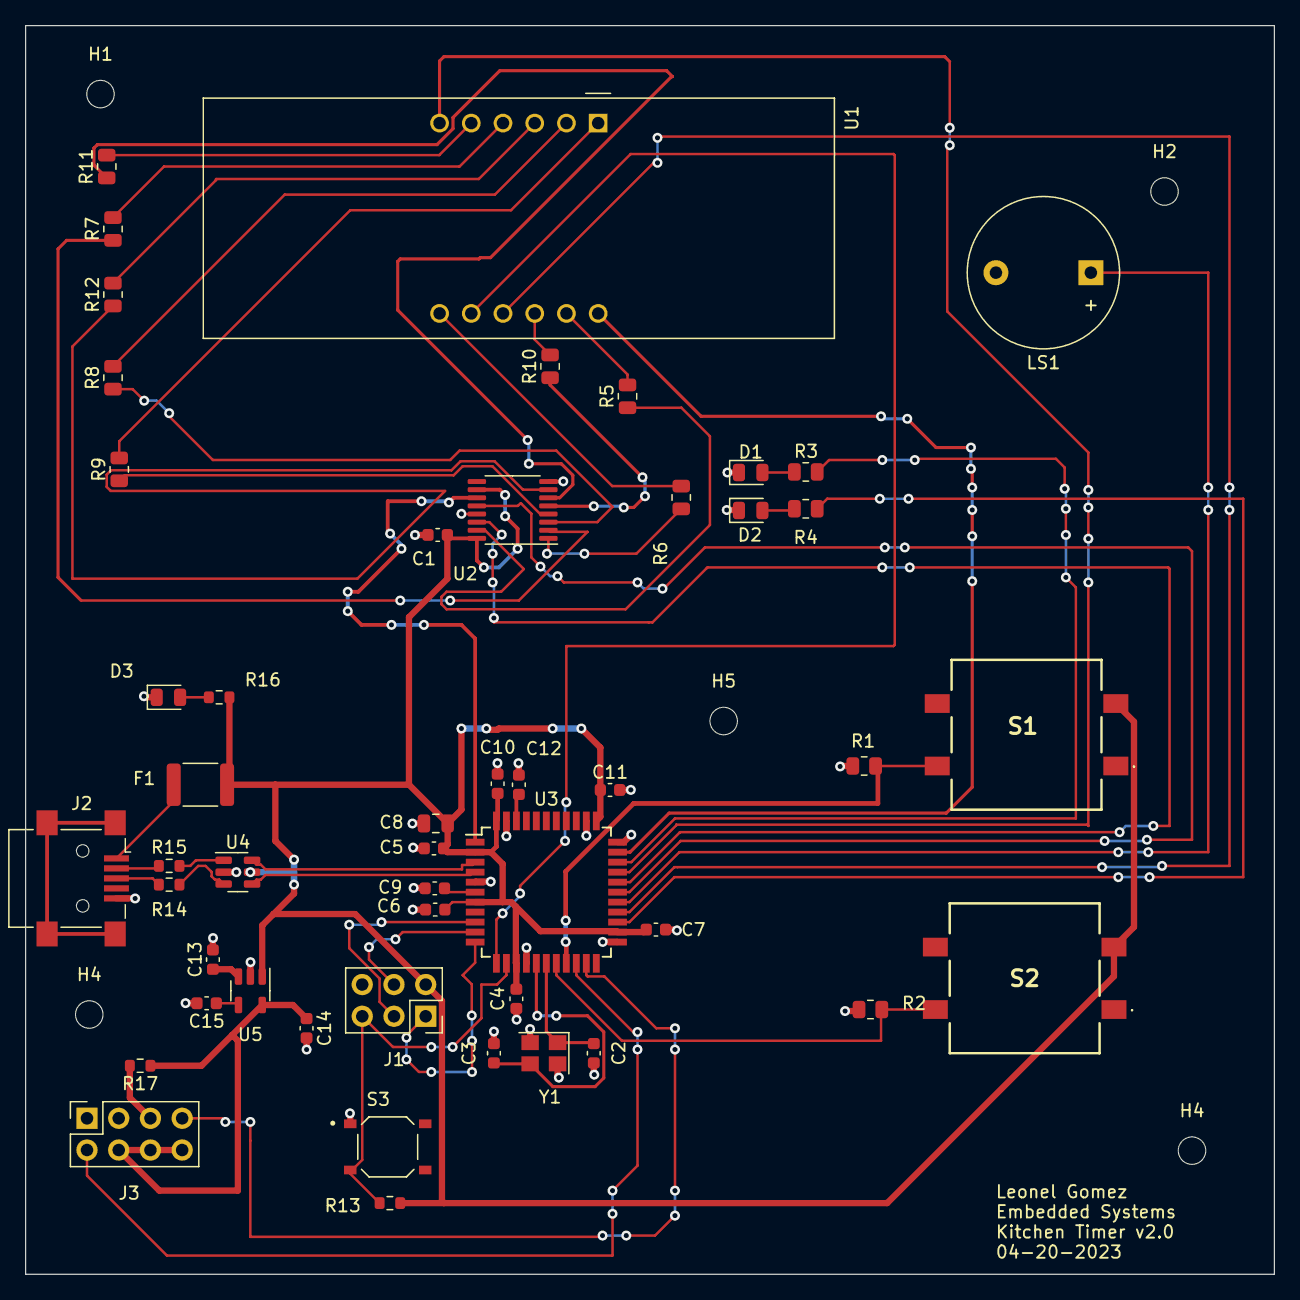
[picture p46: board Phase_B_ATMEGA_v3.kicad_pcb from above]

Board: 2 copper layers, 100.0 x 100.0 mm, 54 parts (0 on the bottom side), 53 nets.

Other parts of the board:
H4#2: MountingHole; MountingHole_2.2mm_M2
