leoki6/ENCE-4321/Phase_A/Arduino_Code/Interrupt_Driven/Interrupt_Driven.ino

#define BUTTON_1  2
#define BUTTON_2  3
#define GREEN_LED 4
#define RED_LED   5

#define DATA      9   
#define LATCH     8  
#define CLOCK     7  

#define DIGIT_4   10
#define DIGIT_3   11
#define DIGIT_2   12
#define DIGIT_1   13
 
unsigned char table[]=
{0x3f,0x06,0x5b,0x4f,0x66,0x6d,0x7d,0x07,0x7f,0x6f,0x77,0x7c
,0x39,0x5e,0x79,0x71,0x00};

volatile int count = 0;

void setup() {
  // LEDs Pins
  pinMode(RED_LED, OUTPUT);
  pinMode(GREEN_LED, OUTPUT);

  // Button Pins
  pinMode(BUTTON_1, INPUT_PULLUP);
  attachInterrupt(digitalPinToInterrupt(BUTTON_1), Button_1_ISR, CHANGE);
  pinMode(BUTTON_2, INPUT_PULLUP);
  attachInterrupt(digitalPinToInterrupt(BUTTON_2), Button_2_ISR, CHANGE);

  // 7-Seg Display
  pinMode(DIGIT_1, OUTPUT);
  pinMode(DIGIT_2, OUTPUT);
  pinMode(DIGIT_3, OUTPUT);
  pinMode(DIGIT_4, OUTPUT);

  // Shift Register Pins
  pinMode(LATCH, OUTPUT);
  pinMode(CLOCK, OUTPUT);
  pinMode(DATA, OUTPUT);

  disp_on();

  // initialize timer1 
  noInterrupts();           // disable all interrupts
  TCCR1A = 0;
  TCCR1B = 0;
  TCNT1  = 0;
  OCR1A = 62500;            // compare match register 16MHz/256
  TCCR1B |= (1 << WGM12);   // CTC mode
  TCCR1B |= (1 << CS12);    // 256 prescaler 
  TIMSK1 |= (1 << OCIE1A);  // enable timer compare interrupt
  interrupts();             // enable all interrupts
}

void Display(unsigned char num)
{

  digitalWrite(LATCH, LOW);
  shiftOut(DATA, CLOCK, MSBFIRST, table[9]);
  digitalWrite(LATCH, HIGH);
}

void Display_Numbers()
{
  Display(count);

  // Reset Counter
  if(count == 16)
  {
    count = 0;
  }
}

void disp_on()
{
   digitalWrite(DIGIT_1, LOW);
   digitalWrite(DIGIT_2, LOW);
   digitalWrite(DIGIT_3, LOW);
   digitalWrite(DIGIT_4, LOW);
}

void Button_1_ISR()
{
  unsigned int buttonState = 0;  // variable for reading the pushbutton status
    
  buttonState = digitalRead(BUTTON_1);
  digitalWrite(RED_LED, buttonState);
}

void Button_2_ISR()
{ 
  unsigned int buttonState = 0;  // variable for reading the pushbutton status
   
  buttonState = digitalRead(BUTTON_2);
  digitalWrite(GREEN_LED, buttonState);
}

ISR(TIMER1_COMPA_vect)          // timer compare interrupt service routine
{
  count++;
  Display_Numbers();
}

void loop() {
  // IDLE
}
