leoki6/ENCE-4321/Phase_D/STM32_Code/V2/Final_Project_V2/class_example/Core/Src/main.c

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
/* Includes ------------------------------------------------------------------*/
#include "main.h"
#include "usb_host.h"

/* USER CODE BEGIN Includes */
#include <string.h>
#include <stdio.h>
#include "ff.h"

/* USER CODE END Includes */

/* USER CODE BEGIN PD */
#define DATA_SIZE 100
/* USER CODE END PD */

ADC_HandleTypeDef hadc1;
ADC_HandleTypeDef hadc2;
UART_HandleTypeDef huart2;


/* USER CODE BEGIN PV */
uint8_t Test[] = "Hello World \r\n"; //Test Data over UART

uint16_t adcData[DATA_SIZE];
uint8_t dataCount = 0;

/* USER CODE END PV */

void SystemClock_Config(void);
static void MX_GPIO_Init(void);
static void MX_ADC1_Init(void);
static void MX_USART2_UART_Init(void);
static void MX_ADC2_Init(void);
void MX_USB_HOST_Process(void);

/**
  * @brief  The application entry point.
  * @retval int
  */
int main(void)
{
  /* USER CODE BEGIN 1 */
  uint16_t raw;
  char msg[10];
  /* USER CODE END 1 */

  /* MCU Configuration--------------------------------------------------------*/

  /* Reset of all peripherals, Initializes the Flash interface and the Systick. */
  HAL_Init();

  /* Configure the system clock */
  SystemClock_Config();

  /* Initialize all configured peripherals */
  MX_GPIO_Init();
  MX_USB_HOST_Init();
  MX_ADC1_Init();
  MX_USART2_UART_Init();
  MX_ADC2_Init();
  /* USER CODE BEGIN 2 */

  //files
  FATFS fs;
  FIL file;

  //create files to store data for testing and observation
  //was not able to completely implement this
  void createFile() {
      f_mount(&fs, "", 1); // Mount the file system

      if (f_open(&file, "adc_data.txt", FA_CREATE_ALWAYS | FA_WRITE) == FR_OK) {
          // File opened successfully
          f_puts("ADC Data:\n", &file);
      } else {
          // Error opening the file
          // Handle the error appropriately
      }
  }

  void writeData(uint16_t data) {
      char buffer[10];
      sprintf(buffer, "%u\n", data);

      if (f_puts(buffer, &file) == -1) {
          // Error writing to the file
          // Handle the error appropriately
      }
  }

  void closeFile() {
      f_close(&file);
      f_mount(NULL, "", 1); // Unmount the file system
  }
  /* USER CODE END 2 */

  /* Infinite loop */
  /* USER CODE BEGIN WHILE */
  while (1)
  {
	  HAL_ADC_Start(&hadc1);
	  HAL_ADC_PollForConversion(&hadc1, HAL_MAX_DELAY);
	  raw = HAL_ADC_GetValue(&hadc1);

	  //transmit to UART via USB to Serial Hardware
	  sprintf(msg, "%hu\r\n", raw);
	  HAL_UART_Transmit(&huart2, (uint_8*)msg, sizeof(msg),HAL_MAX_DELAY);// Sending in normal mode
	  HAL_Delay(1);

	  // Store the ADC data in the array
	  adcData[dataCount] = raw;
	  dataCount++;

	  // Check for collected enough data
	  if (dataCount >= DATA_SIZE)
	  {
		  HAL_GPIO_TogglePin(GPIOD, LD3_Pin);
		  HAL_Delay(500);

		  //reset data struc
		  memset(adcData, 0, sizeof(adcData));

		  dataCount = 0;



    /* USER CODE END WHILE */
    MX_USB_HOST_Process();

    /* USER CODE BEGIN 3 */
  }
  /* USER CODE END 3 */
}

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
