leoki6/ENCE-4321/(commit log)

2023-04-12 Update for files and file structure
    [Phase_A_UnoShield-B_Cu.gbr, Phase_A_UnoShield-B_Mask.gbr, Phase_A_UnoShield-B_Paste.gbr, Phase_A_UnoShield-B_Silkscreen.gbr, Phase_A_UnoShield-Edge_Cuts.gbr, Phase_A_UnoShield-F_Cu.gbr, Phase_A_UnoShield-F_Silkscreen.gbr, Phase_A_UnoShield-NPTH.drl]
2023-04-12 Update: New Block Diags, PCB Files, and Programs for both Phase A & B
    [PTS125_SMD_Button.stp, PTS526_SMD_Button.step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]
2023-04-16 Phase B has received a template. Phase A unchanged.
    [PTS125_SMD_Button.stp, PTS526_SMD_Button.step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]
2023-04-16 Placement Update
    [Phase_B_ATMEGA_v3.kicad_pcb, Phase_B_ATMEGA_v3.kicad_sch]
2023-04-16 readme for kitchen timer update
2023-04-16 Placement Tinkering
    [Phase_B_ATMEGA_v3.kicad_pcb]
2023-04-18 Added housing files and add missing 3d models in PCB viewer for V2
    [PTS125SM73SMTR21M_LFS.stp, PTS526_SM08_SMTR2_LFS.stp, Phase_B_ATMEGA_v3-F_Cu.dxf, Phase_B_ATMEGA_v3.kicad_pcb, part.SLDPRT]
2023-04-18 Routing for V2
    [Phase_B_ATMEGA_v3.kicad_pcb, Phase_B_ATMEGA_v3.kicad_sch]
2023-04-20 Phase B Update: Routing, BOM Files, Drill Files, Gerber Files, and Assembly PDF
    [PTS125SM73SMTR21M_LFS.stp, PTS526_SM08_SMTR2_LFS.stp, Phase_B_ATMEGA_v3-F_Cu.dxf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]
2023-04-20 Schematic Updates, 3D Model PDFs and Images added, etc.
    [Phase_B_ATMEGA_v3.kicad_sch]
2023-04-24 Gerber File Update, Adjusted Board Dimension, etc.
    [Phase_B_ATMEGA_v3-B_Cu.gbr, Phase_B_ATMEGA_v3-B_Mask.gbr, Phase_B_ATMEGA_v3-B_Paste.gbr, Phase_B_ATMEGA_v3-B_Silkscreen.gbr, Phase_B_ATMEGA_v3-Edge_Cuts.gbr, Phase_B_ATMEGA_v3-F_Cu.gbr, Phase_B_ATMEGA_v3-F_Mask.gbr, Phase_B_ATMEGA_v3-F_Paste.gbr]
2023-05-04 Folder Structure Update
    [4.SLDPRT, PTS125SM73SMTR21M_LFS.stp, PTS125_SMD_Button.stp, PTS526_SM08_SMTR2_LFS.stp, PTS526_SMD_Button.step, Phase_A_UnoShield.kicad_sch, Phase_B_ATMEGA_v3-B_Cu.dxf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]
2023-06-01 V1 Prototype Added for Phase D
    [V1.kicad_pcb, V1.kicad_sch]
2023-06-01 Prototype Update
    [V1.kicad_sch]
2023-06-01 STM32 Code Update
2023-06-01 Supporting Doc Update
    [V1.kicad_sch]
2023-06-01 Phase D Update
    [V1-B_Cu.gbr, V1-B_Mask.gbr, V1-B_Paste.gbr, V1-B_Silkscreen.gbr, V1-Edge_Cuts.gbr, V1-F_Cu.gbr, V1-F_Mask.gbr, V1-F_Paste.gbr]
