leoki6/ENCE-4321/(notices)

Notices in the files:
Phase_D/STM32_Code/V1/Final_Project_V1/class_example/Core/Inc/main.h:
Copyright (c) 2023 STMicroelectronics.
All rights reserved.
This software is licensed under terms that can be found in the LICENSE file
